brayit4/WRO2025_Futuroingenieros/others/piezas/ruedasdelante2.jpg

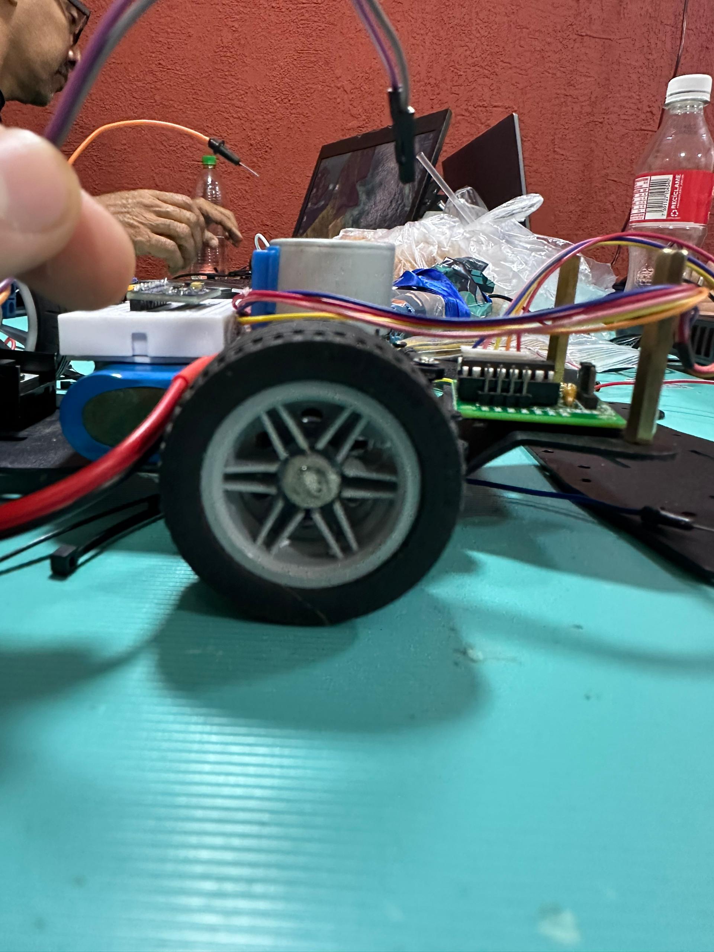
others/piezas/ruedasdelante2.jpg
