brayit4/WRO2025_Futuroingenieros/t-fotos/funnyPhoto.jpg

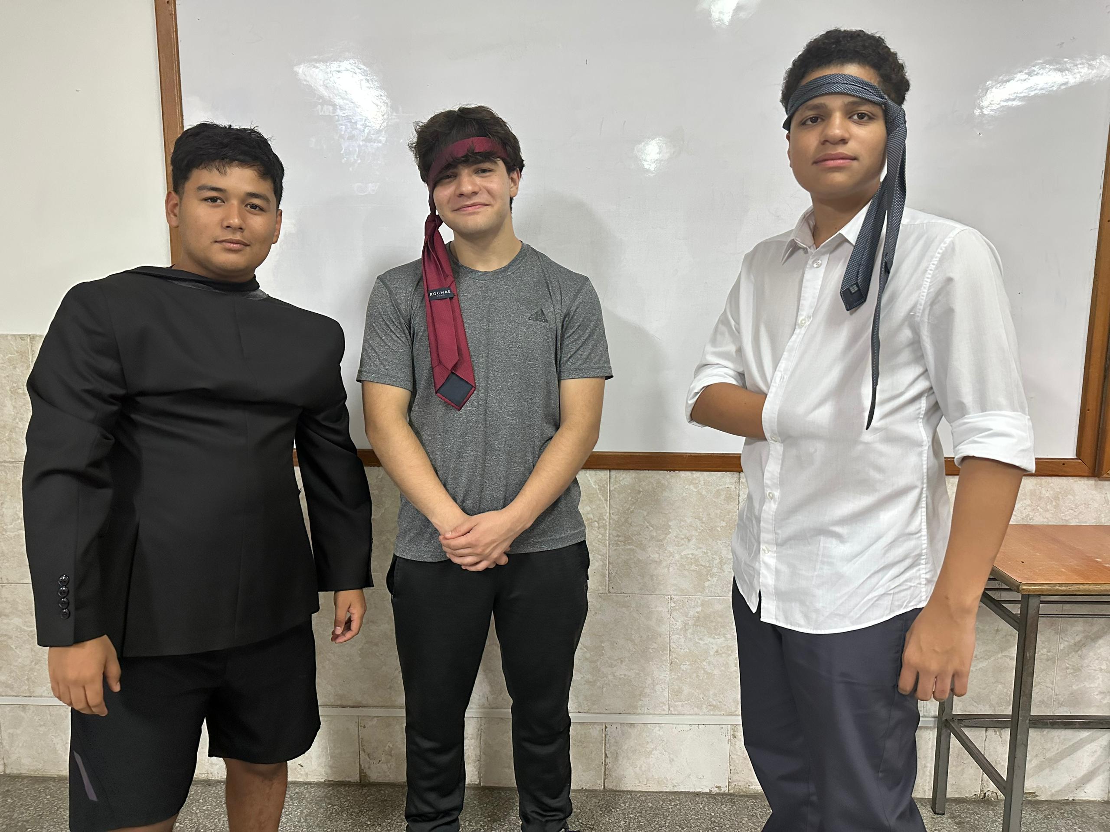
t-fotos/funnyPhoto.jpg
