brayit4/WRO2025_Futuroingenieros/t-fotos/teamphoto.jpg

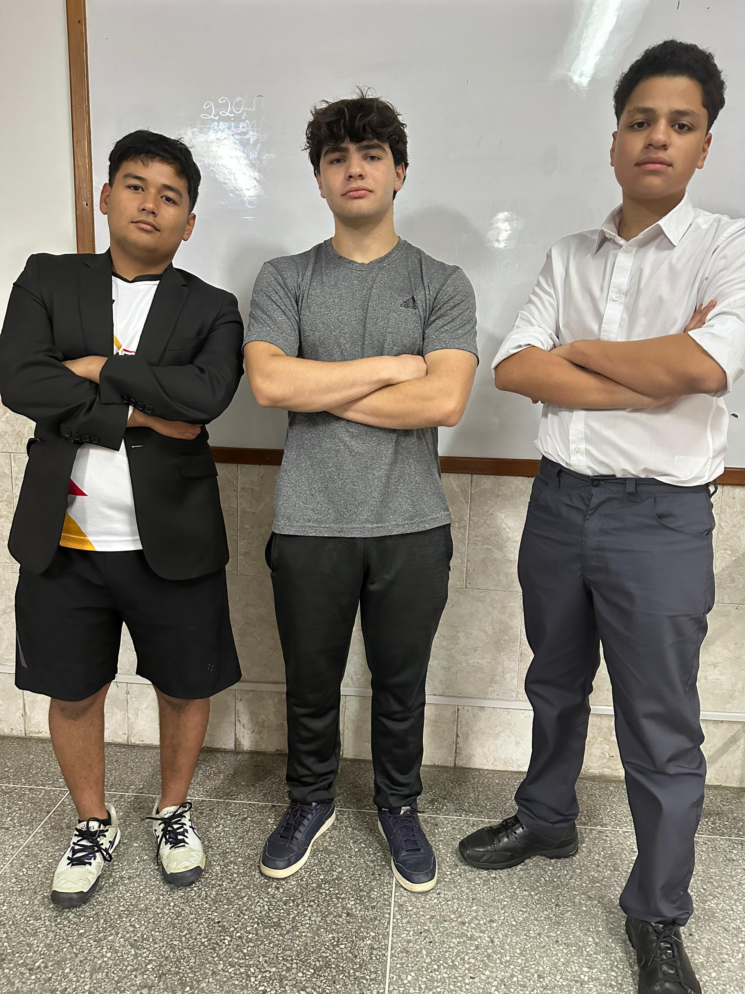
t-fotos/teamphoto.jpg
