brayit4/WRO2025_Futuroingenieros/others/piezas/Resultado de la union de piezas.jpg

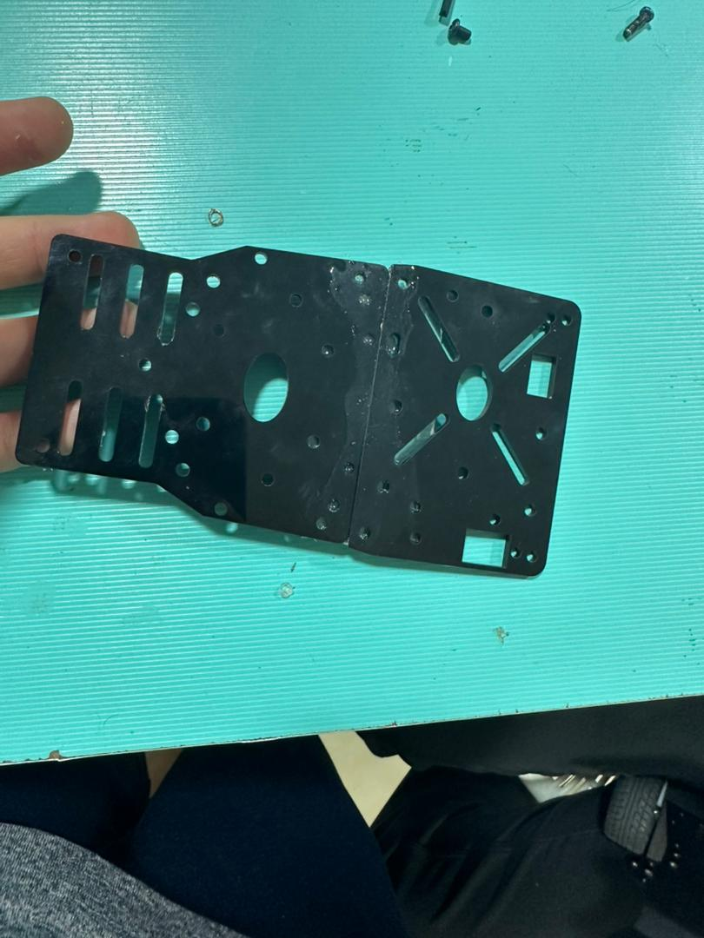
others/piezas/Resultado de la union de piezas.jpg
