brayit4/WRO2025_Futuroingenieros/(commit log)

2025-06-07 Añadidos Pixy cam , sensor de color y Mpu.
2025-06-19 l298n y motor dc
2025-06-19 añadidas baterias y regulador de voltaje Correcciones en los diagramas
2025-06-24 Correciones circuito electrico
